Lich496/75th2600/75th2600内装引き継ぎ.tex

\documentclass[uplatex,dvipdfmx]{jsreport}

\input{docs/settings.tex}

\usepackage{docmute}

\begin{document}

\include{docs/incroduce.tex}

\include{docs/overview.tex}

\include{docs/chronological.tex}

\include{docs/flame.tex}

\end{document}
