Lich496/75th2600/docs/incroduce.tex

\documentclass[uplatex,dvipdfmx]{jsreport}

\input{settings.tex}

\begin{document}

\begin{titlepage}

    \newcommand{\HRule}{\rule{\linewidth}{0.5mm}}
    
    \center
    
    %HEADING SECTIONS
    \LARGE 国立高校\\
    \Large 2021年度 75th 2600\\
    \large 内装設計引き継ぎ (編集中)\\[0.5cm]
    
    %TITLE SECTION
    \hrulefill\\[0.4cm]
    { \huge \bfseries コズミックトラ\rotatebox[origin=c]{-60}{ベ}ル}\\[0.2cm]
    \hrulefill\\[1cm]
    
    \Large \emph{Author:}\\
    内装設計チーフ 千葉森生

    \vfill
    
    %LOGO SECTION
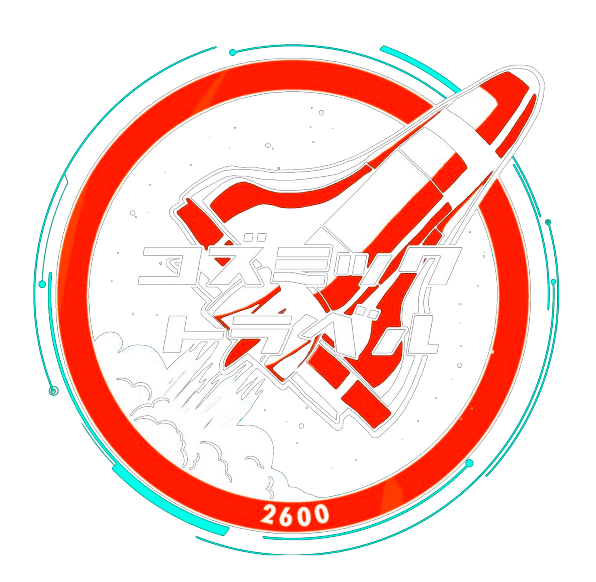
[picture p1: docs/images/logo_t.png]
    

    \vfill
    
    %DATE SECTION
    {最終更新日: \large \today}

    \vfill
    
\end{titlepage}

\tableofcontents

\chapter{まえがき}
\section{ご挨拶}
入試を間近に控えておきながら今更2年生の引き継ぎを書いているのは、3年のはいいから2年の時の引き継ぎをかけと急かされている私、内設チのライド担当の千葉でございます。

軽くプロフィール(肩書き自慢)を書くと、以下のようになります。
\begin{itemize}
    \item 75th2600, 3600内装設計チーフ
    \item 75th2600原案班
    \item エンジニアチームCTO
    \item 帰宅部 etc...
\end{itemize}

で、どんな内装を作ったかと言いますと、

\begin{imageHere}{設計概観}
    
\end{imageHere}

こんなのです。真ん中の正六角形の宇宙船に人を2,3人乗せて回しました。そのため、その辺りの補強が割とエグいです。
今後ライドをやるクラスの参考になれば幸いです。
なお、設計チーフの身ながら内チの仕事に近いところまで手を伸ばしていたので、割と手広い引き継ぎになってます。

デザインが論文っぽいのは\LaTeX{}で書いてるからです。あと、資料は全部別ファイルで添付して、一部のみ引用してきてます。詳しく見たければ添付ファイルへgo。

\clearpage

\section{TL;DR}
TL;DRってIT界隈でしか通じないらしいですね。Too Long, Don't Readの略で、要約みたいな意味のスラングです。

で、要約、というか伝えたいこと。主に心構え的なこととか。

\begin{itemize}
    \item デザインを待っていたら設計は終わらない。設チが先導せよ。
    \item 目標は高く持った方がいい。ただし周りのアドバイスは聞こう。
    \item 外装との連携は忘れずに。双方の進捗を見て人員とか作業スペースとか融通しよう。
    \item 教室測定は念入りに。正確に。細部まで。
\end{itemize}

あと、引き継ぎの内容についてでもそれ以外でも、何か質問があればこちらのメールアドレスまでお気軽に:  chibam496@gmail.com

\end{document}
