Lich496/75th2600/docs/settings.tex

%\usepackage{luatexja}
\usepackage{docmute}

%\usepackage[2.0]{bxpdfver}

\usepackage{graphicx}

\usepackage{xcolor}
\graphicspath{{./docs/images/}{./images/}}
\definecolor{forground}{gray}{0.75}
\definecolor{background}{gray}{0.10}
\color{forground}
\pagecolor{background}

\usepackage{siunitx}

\usepackage{tikz}
\usetikzlibrary{intersections,calc,arrows.meta}

%\usepackage[style=base]{caption}
\usepackage[subrefformat=parens]{subcaption}

\usepackage{prettyref}
\newrefformat{note}{脚注~\ref*{#1}}
\newrefformat{figs}{図~\ref*{#1}}
\newrefformat{fig}{図~\ref*{#1}}
\newrefformat{tbl}{表~\ref*{#1}}
\newcommand*{\fullref}[1]{\hyperref[#1]{\prettyref{#1}}}

\usepackage[pdfusetitle,hidelinks]{hyperref}
\usepackage{pxjahyper}

\newcommand*{\includefig}[5][c]{%
    \begin{minipage}[#1]{#2\linewidth}
        \centering
        
        \subcaption{#3}
        \label{#4}
    \end{minipage}
}
\newenvironment{imageHere}[2][htbp]{\def\@imageHereTmp{#2}%
    \begin{figure}[#1]
        \centering
}{%  
        \caption{\@imageHereTmp}
        \label{figs:\@imageHereTmp}
    \end{figure}
}

\title{
    コズミックトラベル (編集中) \\
    \large 75th2600内装設計チーフ引き継ぎ
}
\author{75th621 千葉森生}
\date{最終更新日: \today}
