Lich496/75th2600/関連ファイル/原案/3.19_ストーリー案.docx

ストーリー

20XX年、人類の宇宙との距離は限りなく近くなった。これは、そんな時代に宇宙旅行に出発した者たちの物語。楽しい宇宙旅行は順調に進んでいたが、出発からしばらくたった後、快適な旅路は終わりを告げる。突然のエンジントラブルによって、船の方向転換ができなくなり、さらに不幸なことに、船の進行方向に不可避の隕石が！隕石との衝突を防ぐためには衝突の前にエンジンを修理してよけるしかない！乗員は最悪な結末を防ぐことができるのか！？この夏、最高にスリリングな体験が君を待っている！

メリット

トゥルーエンドとバッドエンドがわかりやすい

広告映像にオチを付けやすい。爆発オチは正義。

デメリット

結末が二通りだけ
