Lich496/75th2600/関連ファイル/原案/ミニゲームプレゼン資料/岡部/ミニゲーム.pptx

## ミニゲーム！

## 内容

宝探し&パズル

## あらすじ

1. 宇宙旅行へようこそ！
2. 途中で不具合→船外を探査する必要が...
3. ゲストに探査ロボットを組み立ててもらう→パーツは船内から見つけだす
4. 全部の部屋がロボットを組み立てる→地球
2部屋だけ→緊急着陸→火星

## ゲストの動き

1. タラップにて説明を受ける→世界観に導入& 伏線引いとく
2. 宇宙船に乗り込む→景色を楽しむ
3. 宇宙船に不具合→ロボットのパーツ探し& 組み立て
4. 各部屋1体ずつ組み立てる
5. ライド終了→プロジェクションマッピング 見る

## メリット

- ストーリー性強い
- 船外をあまり使わない ＝ゲストが教室内待機◯ スタッフ・機材のスペース確保◯
- 新しいタイプのミニゲーム

## デメリット

- 船内を凝る必要ある
- 難易度をどう調整するか
- 表に出るキャストの負担大
- ロボット&プロジェクションマッピングのクオリティの影響大

## ロボット

- ロボットの形作りでいいと思う
- 部屋ごとにデザイン変える？
- 船内に似たパーツ複数用意→どれでしょう
- どうやって安全なものをつくるか

## ありがとうございましたm(_ _)m
