Lich496/75th2600/関連ファイル/設計図/木!!!!!!!!!!!!!!!!!/木材シール.pdf

内
100

直角台形 60°

船1 | 内
100

直角台形 60°

船4 | 内
110

直角台形 60°

船1 | 内
110

直角台形 60°

船4

内
100

直角台形 60°

船1 | 内
100

直角台形 60°

船4 | 内
110

直角台形 60°

船1 | 内
110

直角台形 60°

船4

内
100

直角台形 60°

船2 | 内
100

直角台形 60°

船5 | 内
110

直角台形 60°

船2 | 内
110

直角台形 60°

船5

内
100

直角台形 60°

船2 | 内
100

直角台形 60°

船5 | 内
110

直角台形 60°

船2 | 内
110

直角台形 60°

船5

内
100

直角台形 60°

船3 | 内
100

直角台形 60°

船6 | 内
110

直角台形 60°

船3 | 内
110

直角台形 60°

船6

内
100

直角台形 60°

船3 | 内
100

直角台形 60°

船6 | 内
110

直角台形 60°

船3 | 内
110

直角台形 60°

船6

内
113
船1 | 内
113
船1 | 内
160

等脚台形 45°

船1 | 内
160

船1

内
136
船1 | 内
136
船4 | 内
160

等脚台形 45°

船1 | 内
160

等脚台形 45°

船1

内
136
船1 | 内
136
船4 | 内
160

等脚台形 45°

船1 | 内
160

等脚台形 45°

船1

内
136
船2 | 内
136
船5 | 内
160

等脚台形 45°

船1 | 内
160

等脚台形 45°

船1

内
136
船2 | 内
136
船5 | 内
160

等脚台形 45°

船1 | 内
160

等脚台形 45°

船1

内
136
船3 | 内
136
船6 | 内
160

等脚台形 45°

船1 | 内
160

等脚台形 45°

船1

内
136
船3 | 内
136
船6 | 内
160

等脚台形 45°

船1 | 内
160

等脚台形 45°

船1

内
160
船1 | 内
160
船1 | 内
160
船1 | 内
160

船1

内
160

等脚台形 45°

船1 | 内
160

等脚台形 45°

船1 | 内
160

等脚台形 45°

船1 | 内
160

等脚台形 45°

船1

内
160

等脚台形 45°

船2 | 内
160

等脚台形 45°

船2 | 内
160

等脚台形 45°

船2 | 内
160

等脚台形 45°

船2

内
160

等脚台形 45°

船2 | 内
160

等脚台形 45°

船2 | 内
160

等脚台形 45°

船2 | 内
160

等脚台形 45°

船2

内
160

等脚台形 45°

船2 | 内
160

等脚台形 45°

船2 | 内
160

等脚台形 45°

船2 | 内
160

等脚台形 45°

船2

内
160

等脚台形 45°

船2 | 内
160

等脚台形 45°

船2 | 内
160

等脚台形 45°

船2 | 内
160

等脚台形 45°

船2

内
160

等脚台形 45°

船2 | 内
160

等脚台形 45°

船2 | 内
160

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
船1 | 内
290
船1 | 内
358
船2 | 内
358

船2

内
290
船2 | 内
290
船2 | 内
358
船3 | 内
358

船3

内
290
船3 | 内
290
船3 | 内
358
船4 | 内
358

船4

内
290
船4 | 内
290
船4 | 内
358
船5 | 内
358

船5

内
290
船5 | 内
290
船5 | 内
358
船6 | 内
358

船6

内
290
船6 | 内
290
船6 | 内
398

直角台形 60°

船1 | 内
398

直角台形 60°

船1

内
398

直角台形 60°

船2 | 内
398

直角台形 60°

船2 | 内
418

直角台形 60°

船3 | 内
418

直角台形 60°

船3

内
398

直角台形 60°

船3 | 内
398

直角台形 60°

船3 | 内
418

直角台形 60°

船4 | 内
418

直角台形 60°

船4

内
398

直角台形 60°

船4 | 内
398

直角台形 60°

船4 | 内
418

直角台形 60°

船5 | 内
418

直角台形 60°

船5

内
398

直角台形 60°

船5 | 内
398

直角台形 60°

船5 | 内
418

直角台形 60°

船6 | 内
418

直角台形 60°

船6

内
398

直角台形 60°

船6 | 内
398

直角台形 60°

船6 | 内
440
船2 | 内
440

船2

内
418

直角台形 60°

船1 | 内
418

直角台形 60°

船1 | 内
440
船3 | 内
440

船3

内
418

直角台形 60°

船2 | 内
418

直角台形 60°

船2 | 内
440
船4 | 内
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
