Lich496/75th2600/関連ファイル/原案/原案班プレゼン資料/1回目 PDF.pdf

# 宇宙へようこそ

### HELLO, WORLD

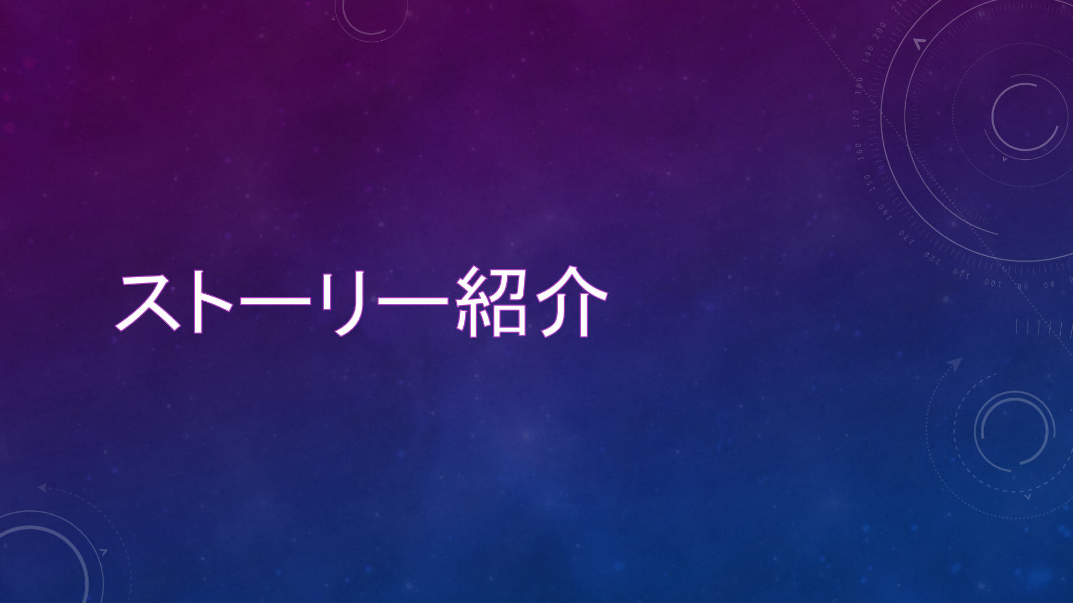
[picture p23: page 2]

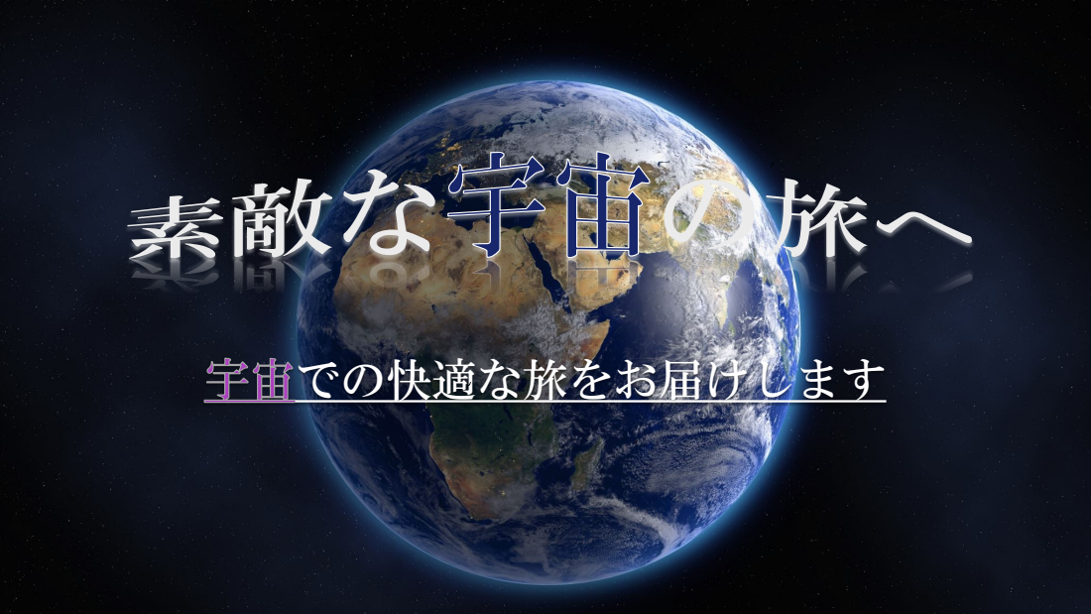
[picture p24: page 3]

# 実際は・・・（＾ω

＾ ）

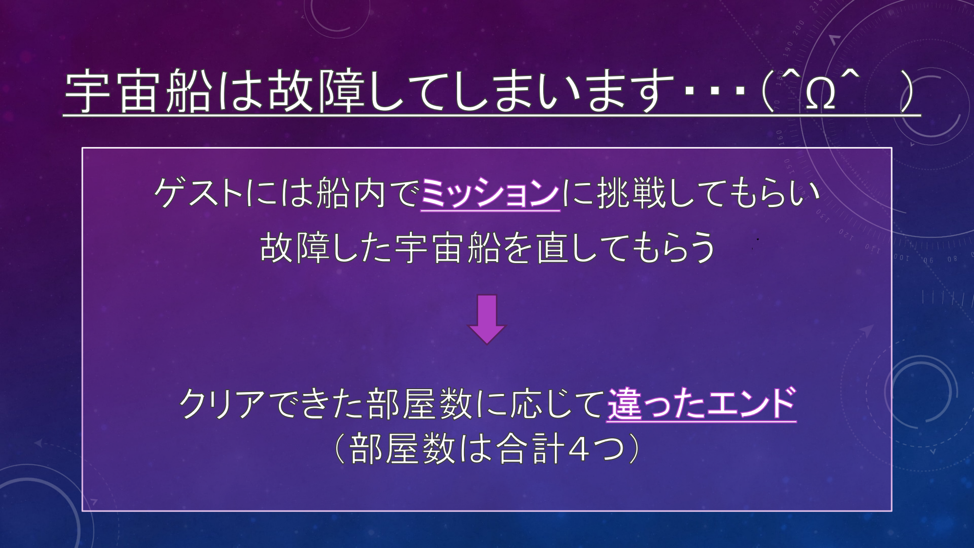
[picture p25: page 5]

## 【全体の流れ】

①ゲストを宇宙船（4つの小部屋）に乗せる

②全員が乗ったら宇宙船を回す

③しばらく時間がたったのち、緊急事態が起こる

④宇宙船修理のミッション（ミニゲーム）が始まる

⑤時間内にクリアできた機体数に応じたエンド

# STRUCTURE

構造

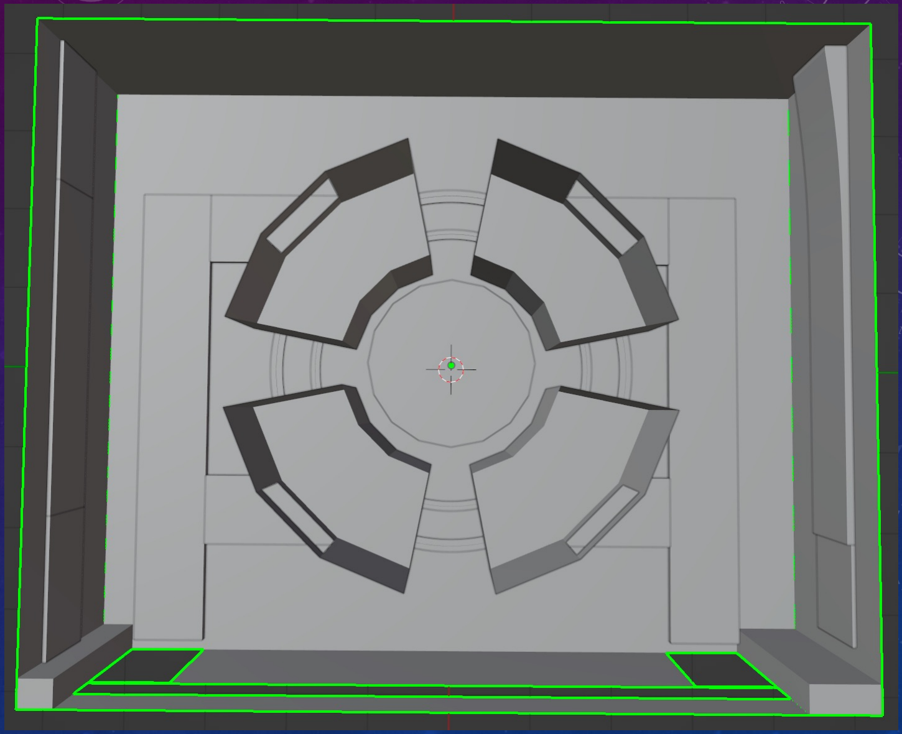
[picture p26: figure]

概要

入り口

### 宇宙船の搭乗口

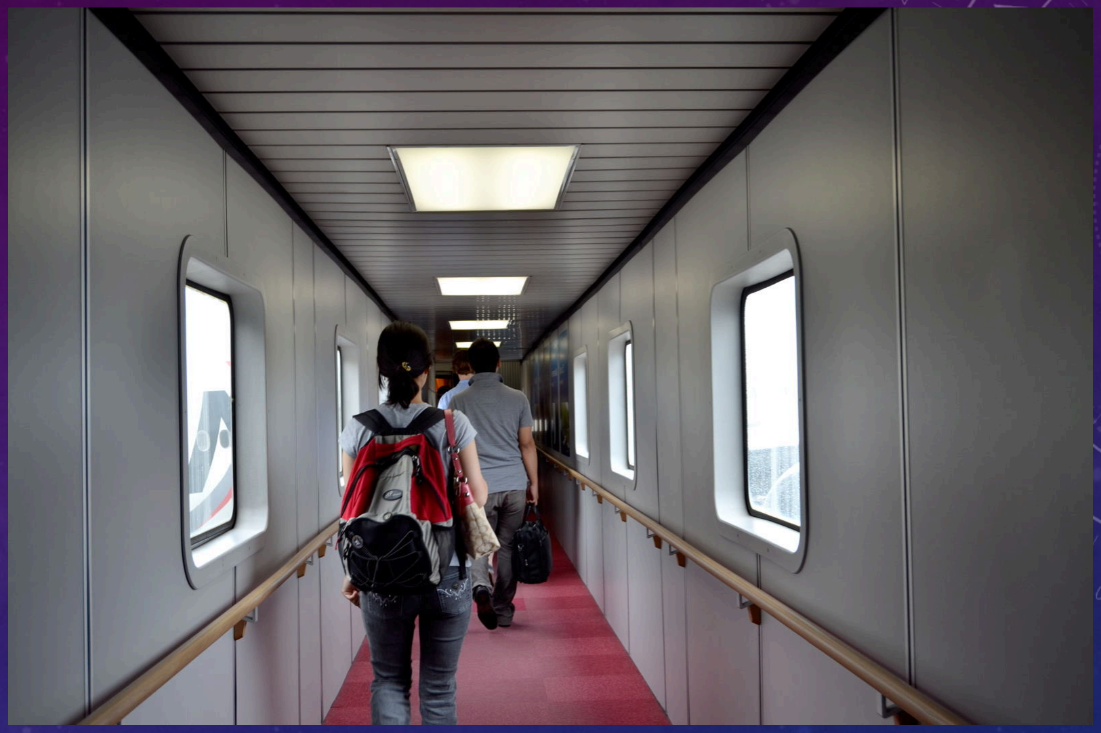
[picture p27: figure]

### 飛行機のタラップのイメージ

内部

### 宇宙船

### 宇宙船修理のミニゲームが隠されている。

出口

### ミニゲームの結果によって分岐

プロジェクションマッピングを使用
(模様のない装飾を用意して、プロジェクターで投影)

駆動部

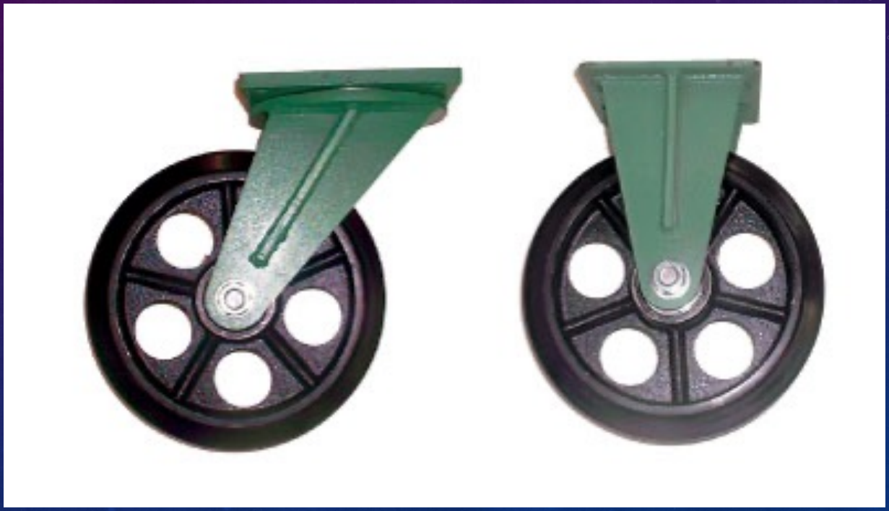
[picture p28: figure]

レール

材質 | 木枠
固定方法 | 壁に押し当てる
本数 | 2本(内側、外側)
形状 | 円形(加工が大変)

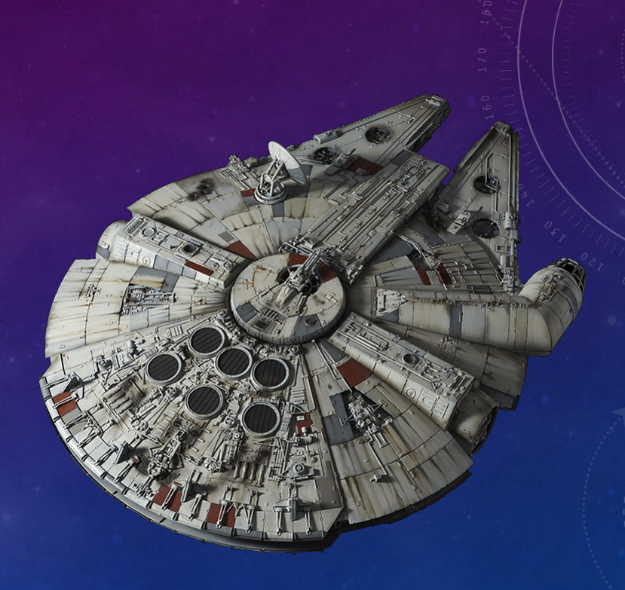
[picture p29: figure]

動力

人力!!

必要人員: 4~8人

必要な人員

動力 | 4~8人
映像 | 1~2人
受付 | 1人
案内 | 3~4人

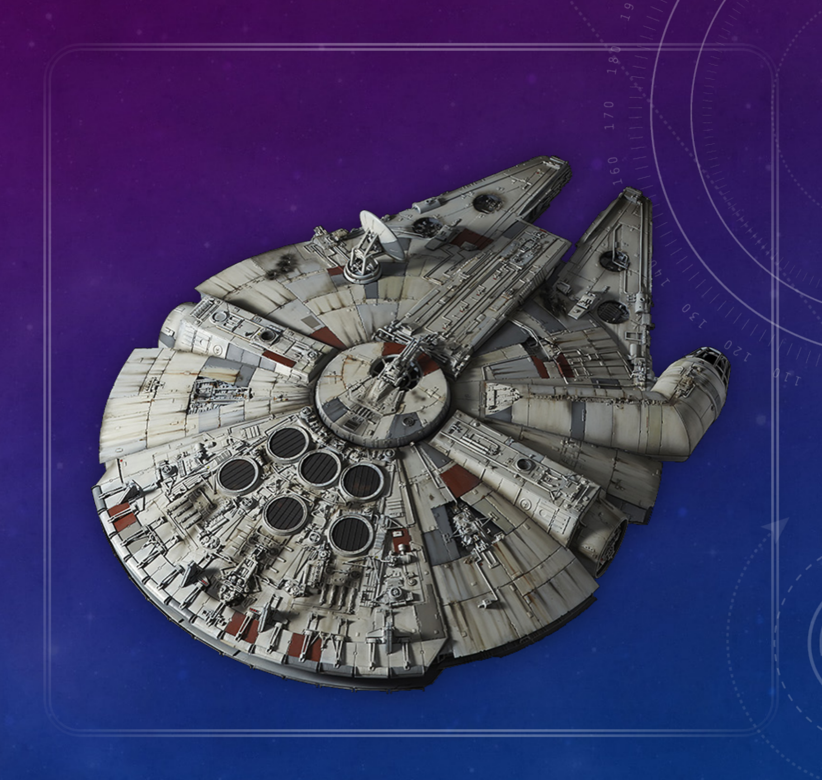
[picture p30: figure]

## Let’s 宇宙旅行!!

Thank you for listening.

宇宙はwi-fi free.
