Lich496/75th2600/docs/images/credit.jpg

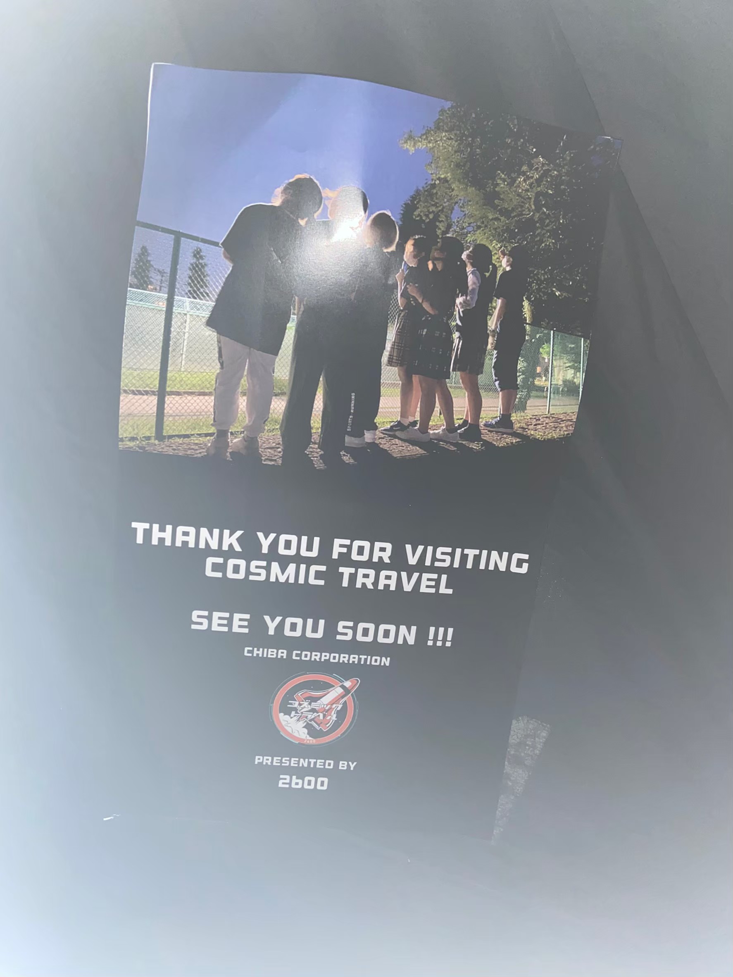
docs/images/credit.jpg
