Lich496/75th2600/docs/images/minigame/1.jpg

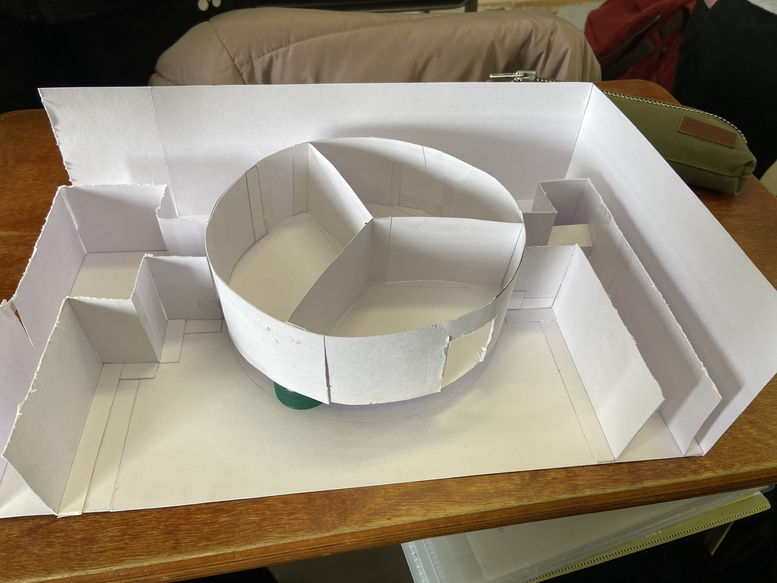
docs/images/minigame/1.jpg
