Lich496/75th2600/docs/images/minigame/2.jpg

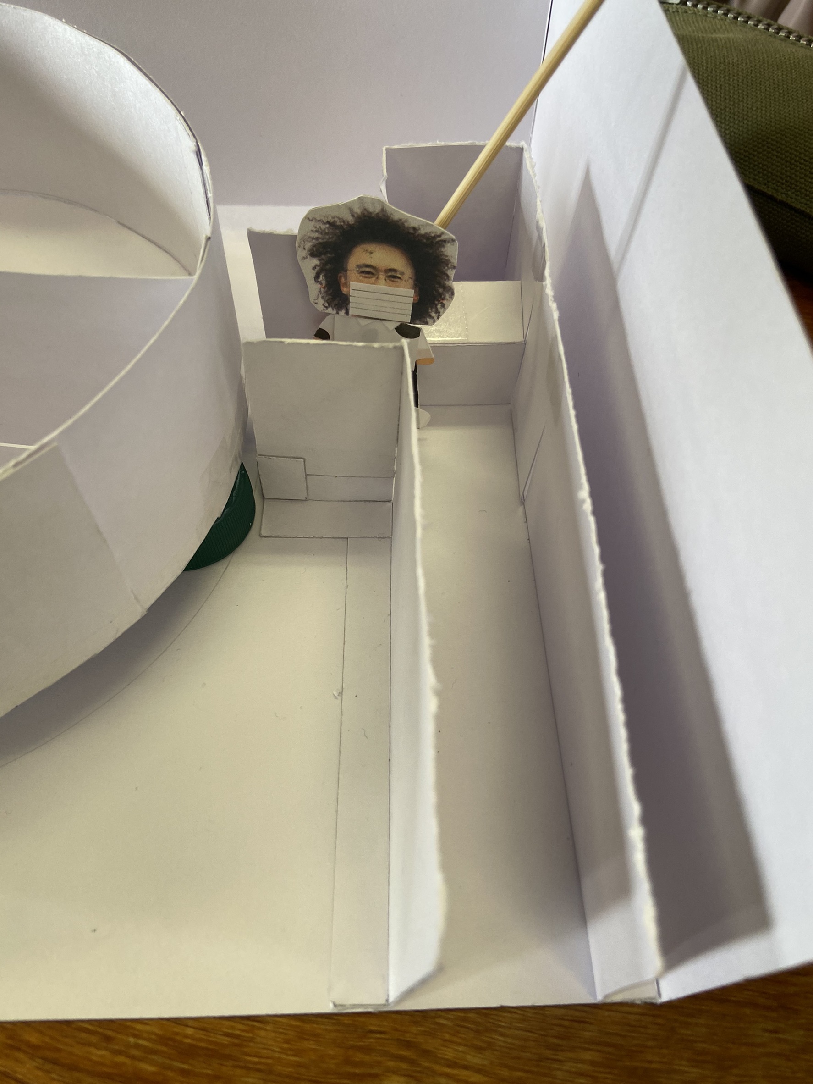
docs/images/minigame/2.jpg
