Lich496/75th2600/docs/images/minigame/3.jpg

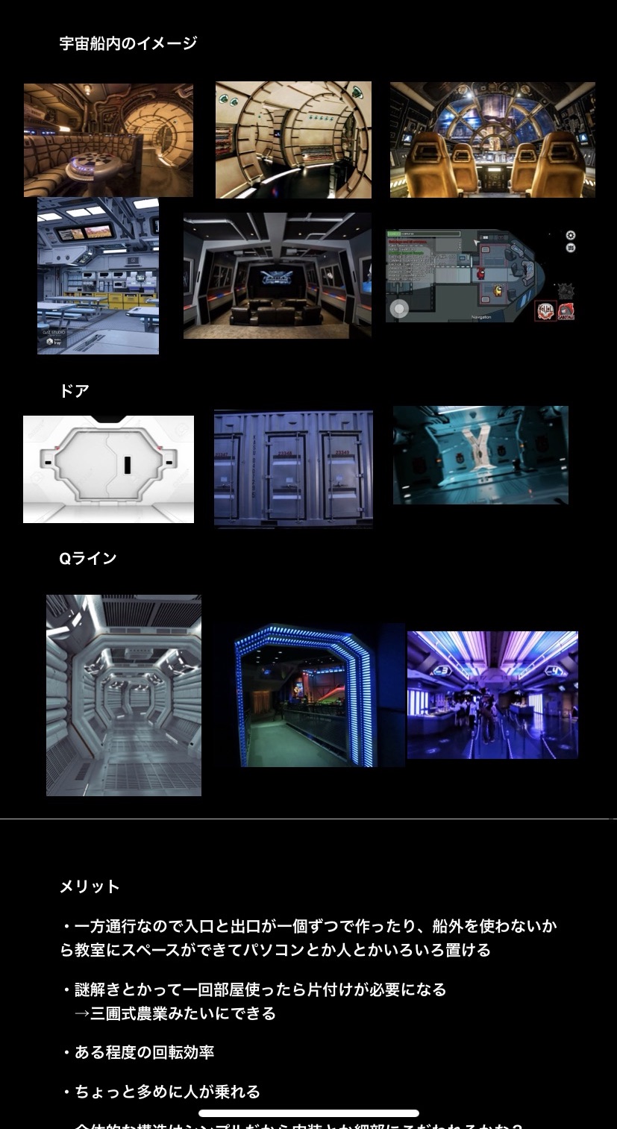
docs/images/minigame/3.jpg
