Lich496/75th2600/docs/images/minigame/4.jpg

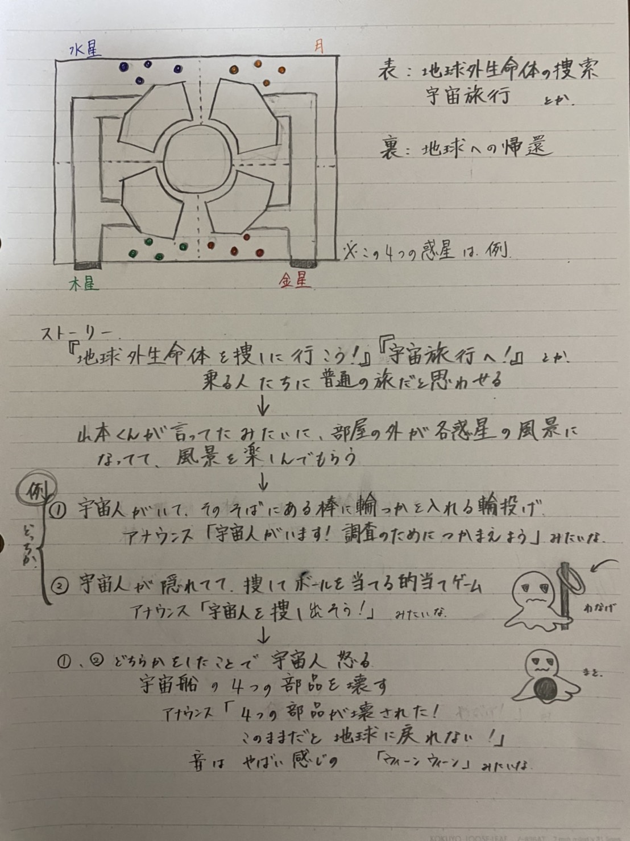
docs/images/minigame/4.jpg
