Lich496/75th2600/docs/images/plan/caster/mono70151953-190930-02.png

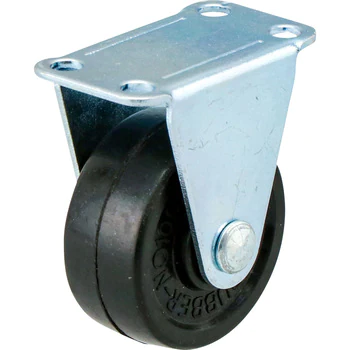
docs/images/plan/caster/mono70151953-190930-02.png
