Lich496/75th2600/docs/images/plan/caster/mono70151978-180403-02.png

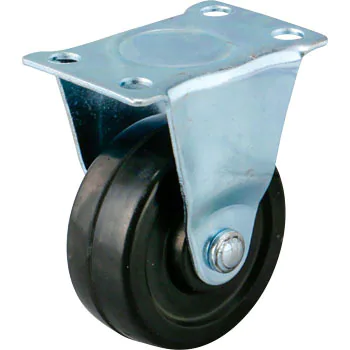
docs/images/plan/caster/mono70151978-180403-02.png
