Lich496/75th2600/docs/images/presentation/3D_model/3D_model_2_2.png

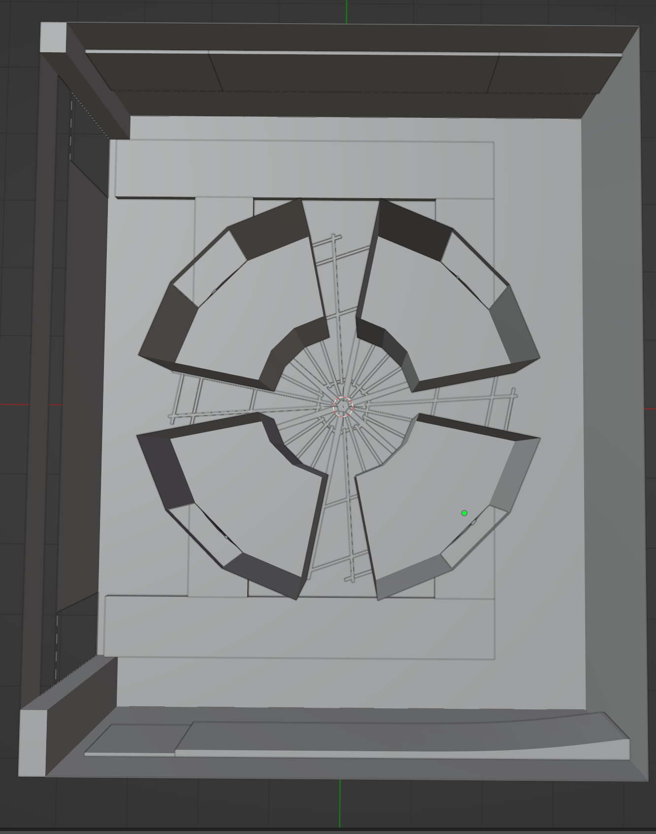
docs/images/presentation/3D_model/3D_model_2_2.png
