Lich496/75th2600/docs/images/presentation/base_bone_1.jpg

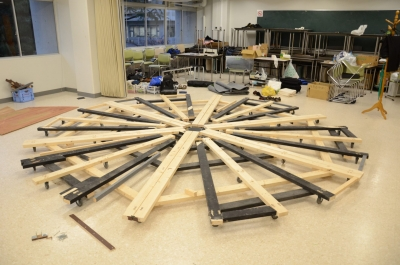
docs/images/presentation/base_bone_1.jpg
