Lich496/75th2600/docs/images/presentation/base_bone_2.jpg

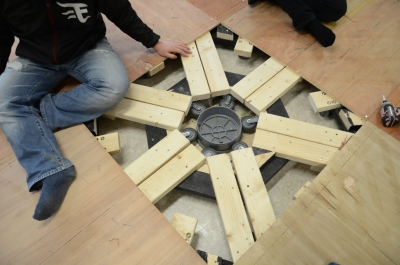
docs/images/presentation/base_bone_2.jpg
