Lich496/75th2600/docs/images/presentation/feedback_2.png

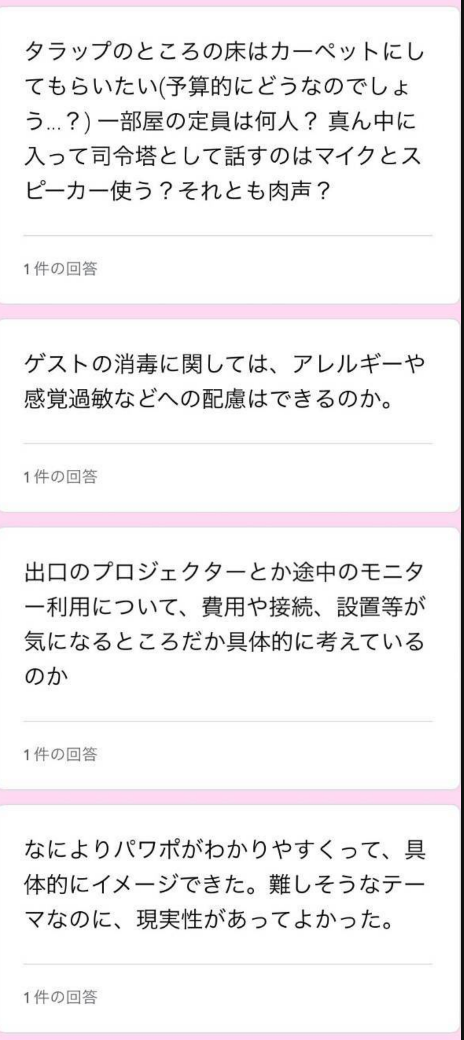
docs/images/presentation/feedback_2.png
