Lich496/75th2600/docs/images/presentation/feedback_3.png

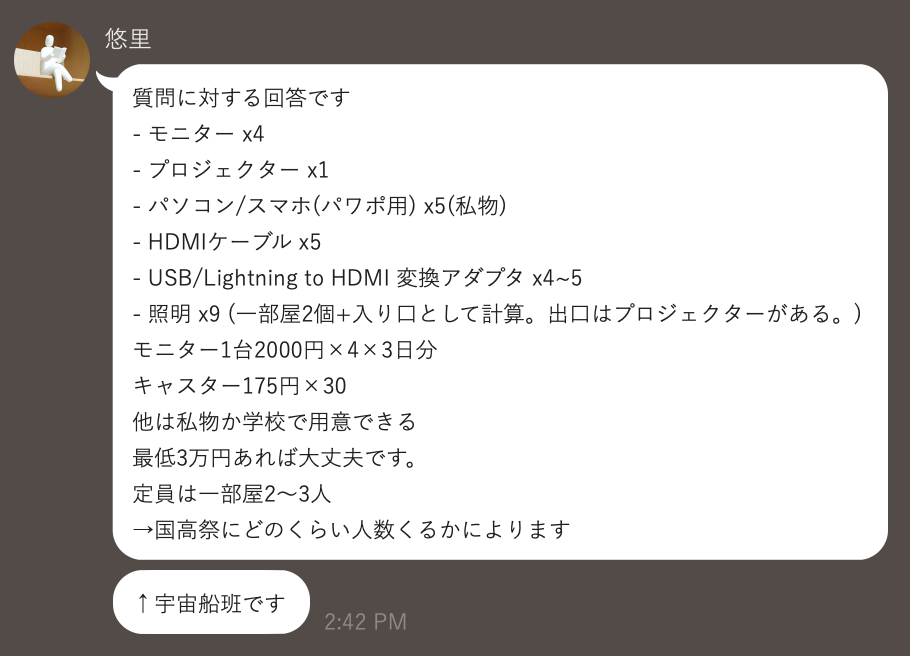
docs/images/presentation/feedback_3.png
