Lich496/75th2600/docs/images/presentation/minigame.jpg

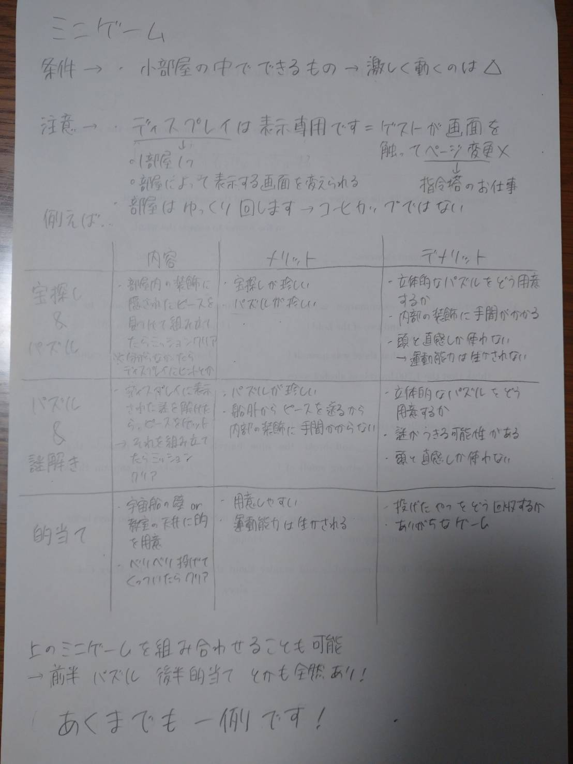
docs/images/presentation/minigame.jpg
