Lich496/75th2600/docs/images/presentation/original_plan.png

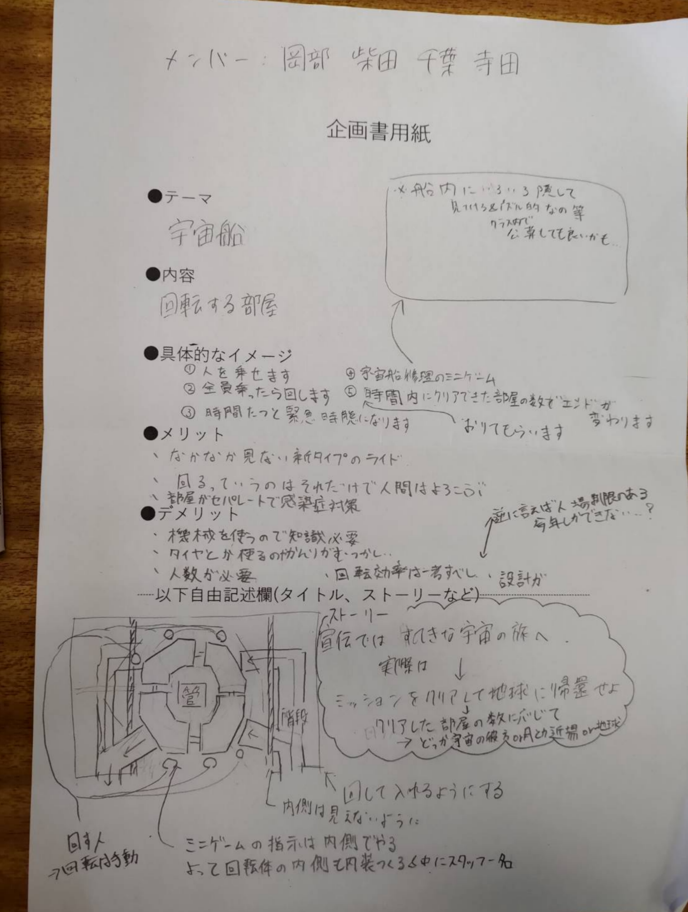
docs/images/presentation/original_plan.png
