Lich496/75th2600/docs/images/presentation/presentation2_1.png

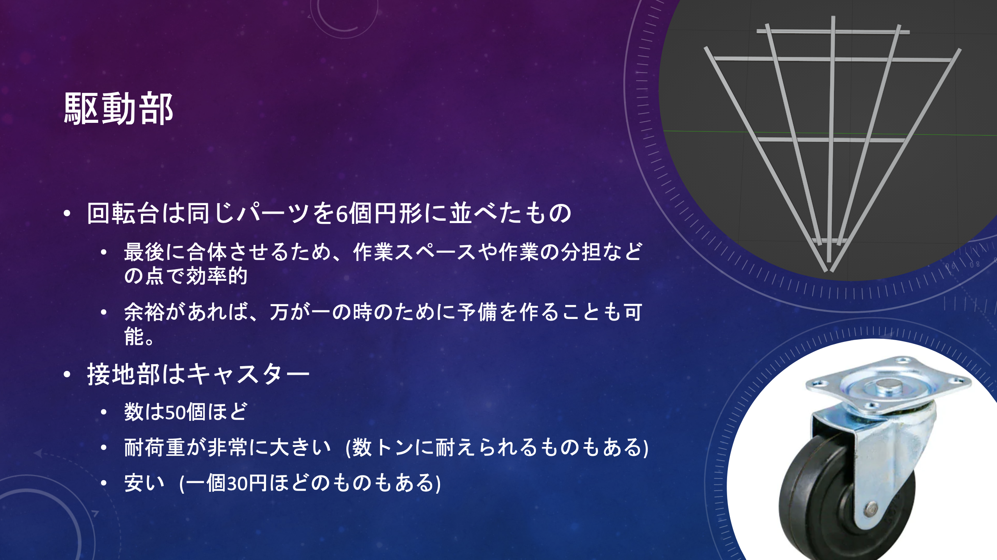
docs/images/presentation/presentation2_1.png
