Lich496/75th2600/関連ファイル/原案/1.13_第1回プレゼン大会/企画書/LINE_ALBUM_221019_4.jpg

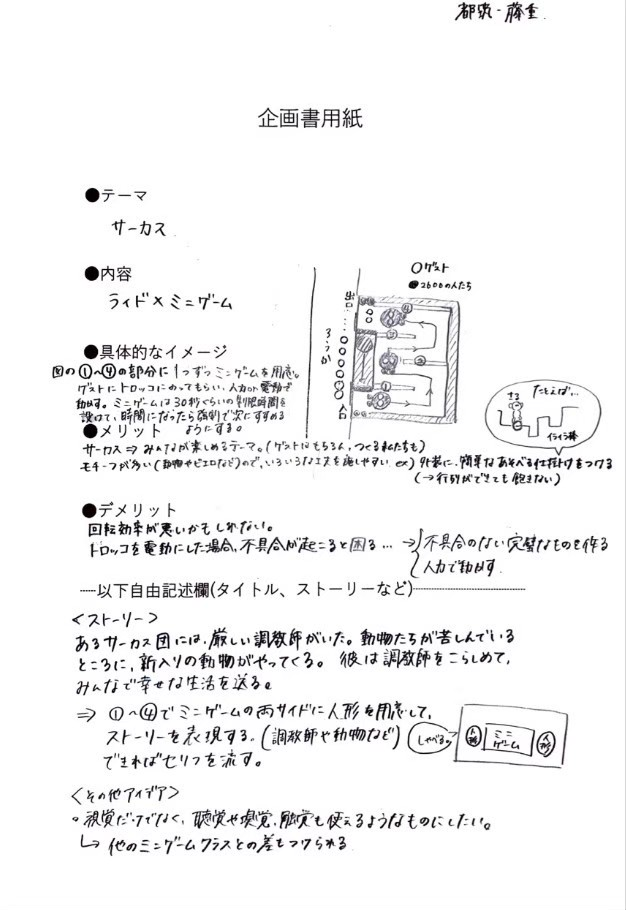
関連ファイル/原案/1.13_第1回プレゼン大会/企画書/LINE_ALBUM_221019_4.jpg
