Lich496/75th2600/関連ファイル/原案/2.10_第2回プレゼン大会/企画書/LINE_ALBUM_221019_1.jpg

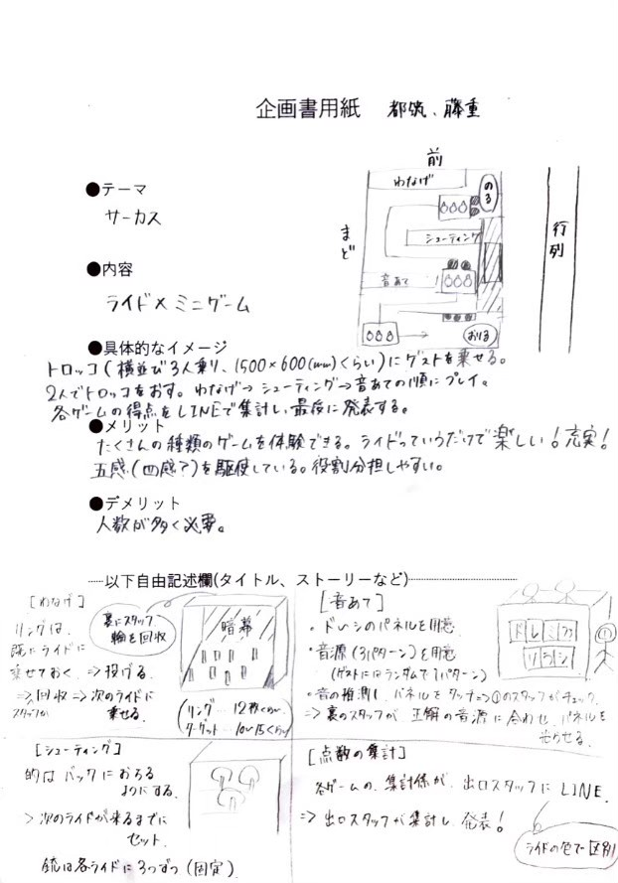
関連ファイル/原案/2.10_第2回プレゼン大会/企画書/LINE_ALBUM_221019_1.jpg
