Lich496/75th2600/関連ファイル/原案/ミニゲームプレゼン資料/佐野/S__26181642.jpg

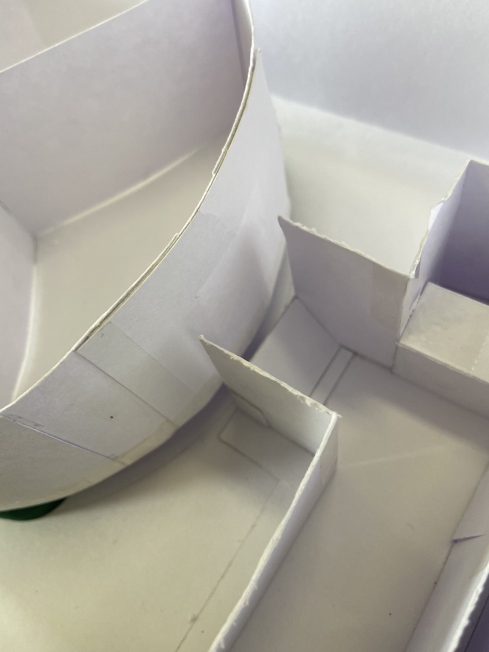
関連ファイル/原案/ミニゲームプレゼン資料/佐野/S__26181642.jpg
