Lich496/75th2600/関連ファイル/原案/ミニゲームプレゼン資料/小川/S__35594245.jpg

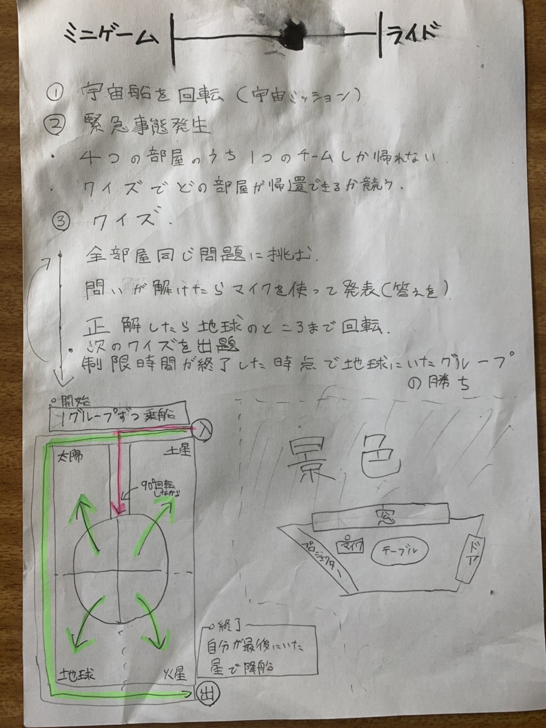
関連ファイル/原案/ミニゲームプレゼン資料/小川/S__35594245.jpg
