Lich496/75th2600/関連ファイル/原案/ミニゲームプレゼン資料/山本/S__30875658.jpg

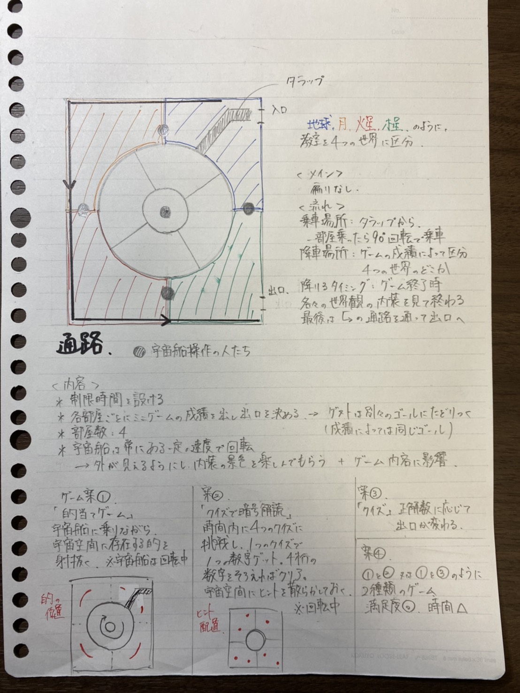
関連ファイル/原案/ミニゲームプレゼン資料/山本/S__30875658.jpg
