Lich496/75th2600/関連ファイル/原案/ミニゲームプレゼン資料/田中/S__37306374.jpg

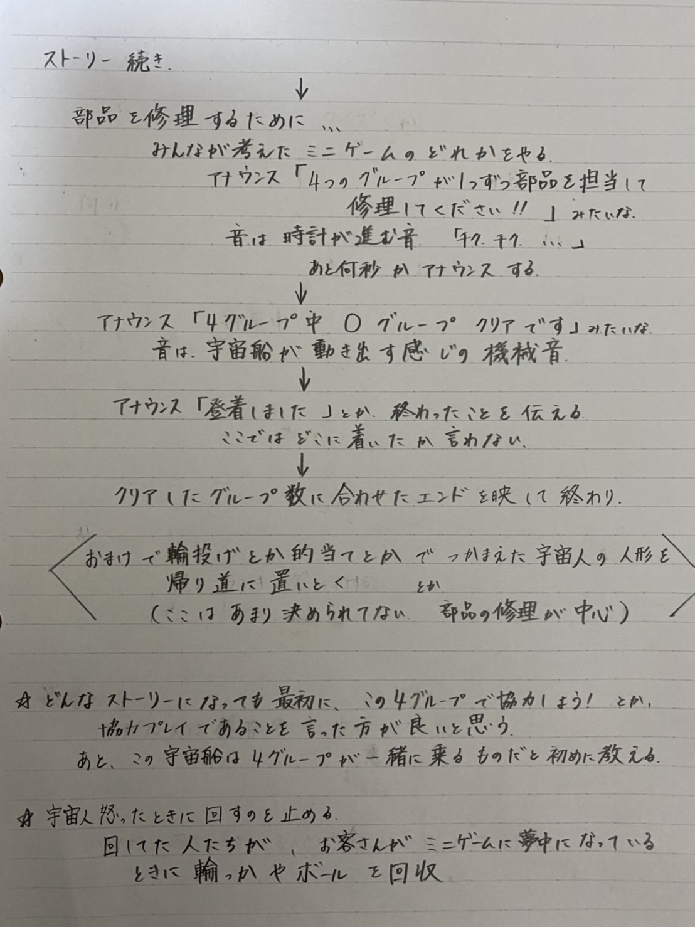
関連ファイル/原案/ミニゲームプレゼン資料/田中/S__37306374.jpg
