Lich496/75th2600/関連ファイル/設計図/写真/69553.jpg

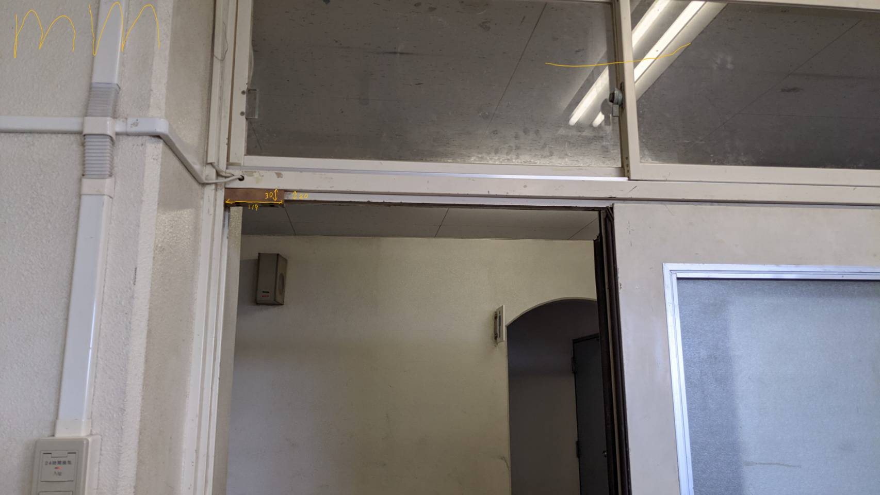
関連ファイル/設計図/写真/69553.jpg
