Lich496/75th2600/(list of files, cad)

Other CAD files:
関連ファイル/原案/原案班プレゼン資料/3Dモデルとか/3Dモデル(blenderファイル).blend
関連ファイル/設計図/2600内装 c1 v1.skp
関連ファイル/設計図/2600内装 c2 v1.skp
関連ファイル/設計図/2600内装 c2 v2.skp
関連ファイル/設計図/2600内装 c2 v2~.skp
関連ファイル/設計図/2600内装 c2 v3.skp
関連ファイル/設計図/2600内装 c2 v3~.skp
関連ファイル/設計図/2600内装 v10.1.skp
関連ファイル/設計図/2600内装 v10.1~.skp
関連ファイル/設計図/2600内装 v10.2.skp
関連ファイル/設計図/2600内装 v10.2~.skp
関連ファイル/設計図/2600内装 v11.2.2.skp
関連ファイル/設計図/2600内装 v11.2.2~.skp
関連ファイル/設計図/2600内装 v11.3color.skp
関連ファイル/設計図/2600内装 v11.4color.skp
関連ファイル/設計図/2600内装 v12.0.skp
関連ファイル/設計図/2600内装 v12.0~.skp
関連ファイル/設計図/2600内装 v12.1.2.skp
関連ファイル/設計図/2600内装 v12.1.skp
関連ファイル/設計図/2600内装 v12.1~.skp
関連ファイル/設計図/2600内装 v12.2.skp
関連ファイル/設計図/2600内装 v12.2~.skp
関連ファイル/設計図/2600内装 v13.2.2.skp
関連ファイル/設計図/2600内装 v13.2.skp
関連ファイル/設計図/2600内装 v13.2~.skp
関連ファイル/設計図/2600内装 v13.3 保存版.skp
関連ファイル/設計図/2600内装 v13.3.skp
関連ファイル/設計図/2600内装 v13.3~.skp
関連ファイル/設計図/2600内装 v13.skp
関連ファイル/設計図/2600内装 v4-5.skp
関連ファイル/設計図/2600内装 v5.1.skp
関連ファイル/設計図/2600内装 v5.1~.skp
関連ファイル/設計図/2600内装 v5.2.skp
関連ファイル/設計図/2600内装 v5.3.skp
関連ファイル/設計図/2600内装 v5.3~.skp
関連ファイル/設計図/2600内装 v5.4.skp
関連ファイル/設計図/2600内装 v5.4~.skp
関連ファイル/設計図/2600内装 v5.skp
関連ファイル/設計図/2600内装 v7.1 木拾い.skp
関連ファイル/設計図/2600内装 v7.1 木拾い~.skp
関連ファイル/設計図/2600内装 v7.1.skp
関連ファイル/設計図/2600内装 v7.1~.skp
関連ファイル/設計図/2600内装 v7.2.skp
関連ファイル/設計図/2600内装 v7.3.skp
関連ファイル/設計図/2600内装 v7.4.skp
関連ファイル/設計図/2600内装 v7.5.skp
関連ファイル/設計図/2600内装 v7.5~.skp
関連ファイル/設計図/2600内装 v8.1.skp
関連ファイル/設計図/2600内装 v8.1~.skp
関連ファイル/設計図/2600内装 v8.2.skp
関連ファイル/設計図/2600内装 v8.2~.skp
関連ファイル/設計図/2600内装 v8.3.skp
関連ファイル/設計図/2600内装 v8.3~.skp
関連ファイル/設計図/2600内装 v8.4 木拾い.skp
関連ファイル/設計図/2600内装 v8.4 木拾い~.skp
関連ファイル/設計図/2600内装 v8.4 木拾い~~.skp
関連ファイル/設計図/2600内装 v8.4.skp
関連ファイル/設計図/2600内装 v8.4~.skp
関連ファイル/設計図/2600内装 v9.1.skp
関連ファイル/設計図/2600内装 v9.1~.skp
関連ファイル/設計図/2600内装 プラダン1.skp
関連ファイル/設計図/2600内装 プラダン1~.skp
関連ファイル/設計図/2600内装 プラダン2.skp
関連ファイル/設計図/2600内装 プラダン2~.skp
関連ファイル/設計図/2600内装 プラダン3.skp
関連ファイル/設計図/2600内装 プラダン3~.skp
関連ファイル/設計図/2600内装 プラダン4.skp
関連ファイル/設計図/2600内装 プラダン4~.skp
関連ファイル/設計図/2600内装 プラダン5.skp
関連ファイル/設計図/2600内装 プラダン5~.skp
関連ファイル/設計図/2600内装 プラダン6.skp
関連ファイル/設計図/2600内装 プラダン7.2.skp
関連ファイル/設計図/2600内装 プラダン7.skp
関連ファイル/設計図/2600内装 プラダン7color.skp
関連ファイル/設計図/2600内装 プラダン7color~.skp
関連ファイル/設計図/2600内装 プラダン7~.skp
関連ファイル/設計図/2600内装 接続部分・キャスター v2.skp
関連ファイル/設計図/2600内装 接続部分・キャスター v2~.skp
関連ファイル/設計図/2600内装 接続部分・キャスター.skp
関連ファイル/設計図/2600内装 操縦席小割.skp
関連ファイル/設計図/2600内装 木材2.skp
関連ファイル/設計図/2600内装 木材3.skp
関連ファイル/設計図/2600内装 木材4.skp
関連ファイル/設計図/2600内装 木材4~.skp
関連ファイル/設計図/2600内装 木材5.skp
関連ファイル/設計図/2600内装 木材5~.skp
関連ファイル/設計図/2600内装 木材6.2.skp
関連ファイル/設計図/2600内装 木材6.2~.skp
関連ファイル/設計図/2600内装 木材6.skp
関連ファイル/設計図/2600内装 木材7.skp
関連ファイル/設計図/2600内装 木材7~.skp
関連ファイル/設計図/2600内装 組み立て v13.2.skp
関連ファイル/設計図/2600内装 軸.skp
関連ファイル/設計図/2600内装 軸~.skp
関連ファイル/設計図/2600内装(1).skp
関連ファイル/設計図/2600内装(1)~.skp
関連ファイル/設計図/75th2600外装(2).skp
関連ファイル/設計図/75th2600外装(2)~.skp
関連ファイル/設計図/内装~.skp
関連ファイル/設計図/内装設計 千葉.skp
関連ファイル/設計図/宇宙船.skp
関連ファイル/設計図/宇宙船~.skp
関連ファイル/設計図/操縦席.skp
関連ファイル/設計図/操縦席v2.skp
関連ファイル/設計図/操縦席v2~.skp
関連ファイル/設計図/操縦席v3.skp
関連ファイル/設計図/操縦席v3~.skp
関連ファイル/設計図/操縦席v4.skp
関連ファイル/設計図/操縦席v4~.skp
関連ファイル/設計図/操縦席v5.skp
関連ファイル/設計図/操縦席v6.skp
関連ファイル/設計図/操縦席v6~.skp
関連ファイル/設計図/操縦席v7.skp
関連ファイル/設計図/操縦席v7p4.skp
関連ファイル/設計図/操縦席v7p4~.skp
関連ファイル/設計図/操縦席v7p4~~.skp
関連ファイル/設計図/操縦席v7~.skp
