Lich496/75th2600/(commit log)

2022-10-18 「案の確定に至るまで」の骨子まで
    [2600内装 v13.3 保存版.skp, 3Dモデル(blenderファイル).blend]
2022-10-18 「案の確定に至るまで」骨子作成
2022-10-18 ファイル構成変更
    [2600内装 v13.3 保存版.skp]
2022-10-19 第二回プレゼン大会まで
2022-10-19 脚注にurl
2022-10-19 フォルダ構成変更
2022-10-23 骨組みに入った。subfigure卒業した。
2022-10-23 設計図全部アップロード、デザインのあたり書いた。
    [2600内装 c1 v1.skp, 2600内装 c2 v1.skp, 2600内装 c2 v2.skp, 2600内装 c2 v2~.skp, 2600内装 c2 v3.skp, 2600内装 c2 v3~.skp, 2600内装 v10.1.skp, 2600内装 v10.1~.skp]
2022-10-24 キャスター、床下
2022-10-24 platexからuplatexに変えたりいろいろ
2022-10-25 細かい修正
2022-10-25 いらないのを削除
2022-10-26 デザイン変えたりいろいろ
2022-10-26 図の修正
